epccs/RPUlux/DayNight/README.md

# Day-Night State Machine

## Overview

Use a red LED's photovoltaic voltage on ADC2 to approximately tell when it is day or night. 

Note: use the Day_AttachDayWork() and Night_AttachWork() functions to set a callback that will be run at the start of each day. This framework is how I debuged the day-night stat machine, it is not expected to be useful.

## Firmware Upload

With a serial port connection (see BOOTLOAD_PORT in Makefilee) and optiboot installed on the RPUlux run 'make bootload' and it should compile and then flash the MCU.

``` 
sudo apt-get install make git gcc-avr binutils-avr gdb-avr avr-libc avrdude
git clone https://github.com/epccs/RPUlux/
cd /RPUlux/DayNight
make bootload
...
avrdude done.  Thank you.
``` 

Now connect with picocom (or ilk).

``` 
#exit is C-a, C-x
picocom -b 38400 /dev/ttyUSB0
``` 

# Commands

Commands are interactive over the serial interface at 38400 baud rate. The echo will start after the second character of a new line. 

## /\[rpu_address\]/\[command \[arg\]\]

rpu_address is taken from the I2C address 0x29 (e.g. ../Uart/id.h get_Rpu_address() ). The value of rpu_address is used as a character in a string, which means don't use a null value (C strings are null terminated), but the ASCII value for '1' (0x31) is easy and looks nice.

The LED_BUILTIN is bliked fast (twice per second) if the I2C address is not found, also the rpu_address defaults to '0'. 

Commands and their arguments follow.

## /0/id? \[name|desc|avr-gcc\]

Identify is from ../Uart/id.h Id().

``` 
/1/id?
{"id":{"name":"DayNight","desc":"RPUlux Board /w atmega328p and LT3652","avr-gcc":"4.9"}}
```

##  /0/day?

Report status of the state machine.

``` 
/1/day?
{"day_state":"DAY"}
... 11 hr
{"day_state":"DAY"}
{"day_state":"EVENING"}
... 15 min
{"day_state":"EVENING"}
TurnOnLED's
{"day_state":"NIGHT"}
... 12 hr
{"day_state":"NIGHT"}
{"day_state":"MORNING"}
... 15 min
{"day_state":"MORNING"}
WaterTheGarden
{"day_state":"DAY"}
... 20 hr (e.g. using an indoor lamp)
{"day_state":"DAY"}
{"day_state":"FAIL"}
```
