epccs/RPUlux/Hardware/Design/17323SMD,BOM.csv

LINE | REF | QTY | EPCCS TYP | EPCCS PN | MFG@PN | DESCRIPTION | NOTES | COST EA | LINE COST | BIN
 |  |  |  |  |  | RPUlux SMD |  |  | TOTAL
 |  |  |  |  |  | 2/23/17 (17323^2) |  |  | =SUM(J5:J100)
1 | C1 C6 C7 | 3 | C-C | 1206X5R50V106K | TDK@C3216X5R1H106K160AB | CAP CER 10UF 50V 10% X5R 1206 | (1) | .3575 | =C5*I5 | CC01
2 | C2 C4 C12 C26 C27 C28 C31 | 7 | C-C | 0603X7R50V104K | TDK@C1608X7R1H104K080AA | CAP CER 0.1UF 50V 10% X7R 0603 | (1) | 0.0055 | =C6*I6 | ADPT
3 | C3 C19 C20 C24 C25 | 5 | C-C | 0603X7R50V103K | MURATA@GRM188R71H103KA01J | CAP CER 10000PF 50V 10% X7R 0603 | (1) | 0.007 | =C7*I7 | HT
4 | C5 C9 C10 C11 C13 C14 C15 C16 C17 C18 C21 C22 C23 | 13 | C-C | 0805X7R50V105K | TAIYO@UMK212B7105KG-T | CAP CER 1UF 50V 10% X7R 0805 | (1) | 0.136 | =C8*I8 | CC01
5 | C8 | 1 | C-T | 106A | AVX@TPSA106K010R0900 | CAP TANT 10UF 10V 10% ESR .9OHM 1206 | (1) | 0.3575 | =C9*I9 | ADPT
6 | C29 C30 | 2 | C-C | 0603NPO50V270J | SAMSUNG@CL10C270JB8NNNC | CAP CER 27PF 50V 5% NPO 0603 | (1) | 0.0067 | =C10*I10 | RPUNO
7 | D1 D3 D4 D5 D6 D7 D8 | 7 | D-SBR | SQ4 | DIODES@SBR2A40SA | DIODE SBR 40V 2A SMA | (1) | 0.289 | =C11*I11 | CC01
8 | D9 | 1 | D-GP | T4 | DIODES@1N4148W-7-F | DIODE SWITCH 100V 0.15A SOD123 | (1) | 0.0601 | =C12*I12 | CC01
9 | L1 L2 L3 L4 L5 L6 | 6 | L-PSMD | 33UH1A1 | TAIYO_YUDEN@NR6028T330M | INDUCTOR POWER SHIELDED 33UH 1A1 SMD | (1 2) | 0.3096 | =C13*I13 | LUX
10 | L7 | 0 | L-FB | MH2029-300Y | BORNS@MH2029-300Y | FERRITE SMDBEAD 30OHM@100MHZ 3A 0805 | (1) | 0.0272 | =C14*I14 | ADPT
11 | Q1 Q6 Q10 Q16 Q20 | 5 | Q-NPN | K1N | DIODES@MMBT3904-7-F | TRANSISTOR NPN GP 40V 200MA SOT23 | (1) | 0.0204 | =C15*I15 | IRRIGATE7
12 | Q2 Q4 Q8 | 3 | Q-PCH | P65 | DIODES@DMP4065S-7 | MOSFET P-CH 2.4A 40V SOT23 | (1) | 0.2196 | =C16*I16 | PUNICA
13 | Q3 Q9 Q11 Q17 Q19 Q21 Q22 | 7 | Q-NCH | K38 | DIODES@BSS138-7-F | MOSFET N-CH 200MA 50V SOT23 | (1) | 0.1132 | =C17*I17 | ADPT
14 | Q5 Q7 Q12 Q13 Q18 Q23 | 6 | Q-PNP | K3N | DIODES@MMBT3906-7-F | TRANSISTOR PNP GP 40V 200MA SOT23 | (1) | 0.0204 | =C18*I18 | HT
15 | Q14 Q15 | 2 | Q-NCH | 34N | DIODES@DMN3404L-7 | MOSFET N-CH 5.8A 30V SOT23 | (1) | 0.1351 | =C19*I19 | IRRIGATE7
16 | R1 R11 R14 R15 | 4 | R-C | 0805KX1003 | YAGEO@RC0805FR-07100KL | RESISTOR CHIP 1% 100KOHM 0805 | (1) | 0.0025 | =C20*I20 | IRRIGATE7
17 | R2 R16 R38 | 3 | R-C | 0805KX4992 | YAGEO@RC0805FR-0749K9L | RESISTOR CHIP 1% 49K9OHM 0805 | (1) | 0.0064 | =C21*I21 | IRRIGATE7
18 | R3 R8 R9 R27 R28 R39 R40 R41 | 8 | R-C | 0805KX1002 | YAGEO@RC0805FR-0710KL | RESISTOR CHIP 1% 10KOHM 0805 | (1) | 0.0025 | =C22*I22 | ADPT
19 | R4 | 1 | R-C | 0805KX1001 | YAGEO@RC0805FR-071KL | RESISTOR CHIP 1% 1KOHM 0805 | (1) | 0.0025 | =C23*I23 | HT
20 | R5 R36 | 2 | R-C | 0805FX1003 | YAGEO@RT0805BRD07100KL | RESISTOR CHIP 0.1% 100KOHM 0805 | (1) | 0.1277 | =C24*I24 | LUX
21 | R6 R35 | 2 | R-C | 0805KX1582 | YAGEO@RC0805FR-0715K8L | RESISTOR CHIP 1% 15K8OHM 0805 | (1) | 0.0064 | =C25*I25 | IRRIGATE7
22 | R7 | 1 | R-C | 0805KX0R068 | SAMSUNG@RU2012FR068CS | RESISTOR CHIP 1% 0R068OHM 0805 | (7) | 0.0899 | =C26*I26 | CC03
23 | R10 | 0 |  | JMP |  |  |  | 0.0 | =C27*I27 | NA
24 | R12 | 0 |  | OPEN |  |  |  | 0.0 | =C28*I28 | NA
25 | R13 | 1 | R-C | 0805KX8062 | YAGEO@RC0805FR-0780K6L | RESISTOR CHIP 1% 80K6OHM 0805 | (1) | 0.0064 | =C29*I29 | CC01
26 | R17 R26 | 2 | R-C | 0805KX27R0 | YAGEO@RC0805FR-0727R0L | RESISTOR CHIP 1% 27R0OHM 0805 | (1) | 0.0064 | =C30*I30 | FTDI
27 | R18 R20 R22 R29 R31 R33 | 6 | R-C | 0805KX0R300 | SUSUMU@RL1220S-R30-F | RESISTOR CHIP 1% 0R300OHM 0805 | (7) | 0.1043 | =C31*I31 | LUX
28 | R19 R21 R23 R30 R32 R34 | 6 | R-C | 0805KX3741 | YAGEO@RC0805FR-073K74L | RESISTOR CHIP 1% 3K74OHM 0805 | (1) | 0.0064 | =C32*I32 | PDAQ
29 | R24 R25 R37 | 3 | R-C | 0805KX127R | YAGEO@RC0805FR-07127RL | RESISTOR CHIP 1% 127OHM 0805 | (1) | 0.0024 | =C33*I33 | PUNICA
30 | U1 | 1 | U-LINEAR | 1087 | DIODES@ZXCT1087E5TA | HISIDE CURRENT MONITOR SOT23-5 | (1) | 1.0661 | =C34*I34 | CCTEST
31 | U3 U4 U5 U6 U7 U8 | 6 | U-LINEAR | A6 | DIODES@AL8805W5-7 | CURR DRIVER SOT23-5 | (1) | 0.8110 | =C35*I35 | LUX
32 | U9 | 1 | U-AVR | MEGA328P | ATMEL@ATMEGA328P-AU | MCU AVR8 32KB FLASH 20MHZ 32TQFP | () | 1.9504 | =C36*I36 | RPUNO
33 | Y1 | 1 | Y-XTL | 16MHZ20 | ECS@ECS-160-20-3X-TR | CRYSTAL 16MHZ 20PF 30PPM CSM-3X | (1) | 0.315 | =C37*I37 | RPUNO
 |  |  |  |  |  | NOTES
 |  |  |  |  |  | (1) Alternate part with same or better rating allowed
 |  |  |  |  |  | (2) SMD pads are wide but also works with TAIYO_YUDEN@NR5040T330M
