epccs/RPUlux/SelfTest/README.md

# Self-Test

## Overview

Check RPUlux Board Functions, runs once after a reset and then loops in a pass/fail section.

Voltage references are saved in EEPROM for use with Adc and other applications. Measure the +5V supply accurately and set the REF_EXTERN_AVCC value in the main.c file. The band-gap reference is calculated and also saved.

The wiring has red and green LED that blink to indicate test status.

## Wiring Needed for RPUlux

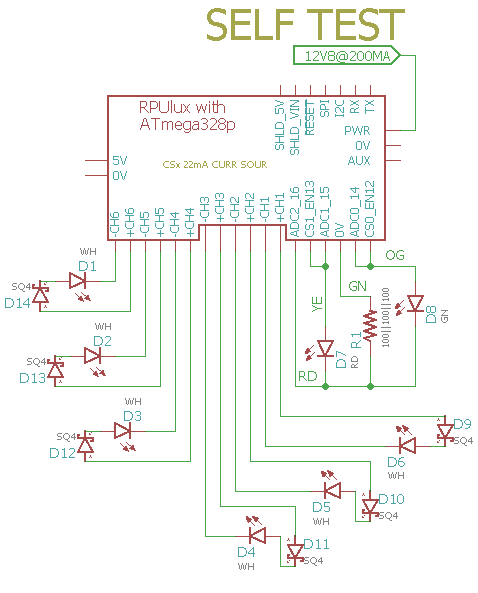
[picture p29: SelfTest/Setup/SelfTestWiring.png]
Wiring


Note: blocking diode with LED is to prevent damage when connected wrong.

## Power Supply

Connect a power supply with CV and CC mode. Set CC at 300mA then increase CV to 12.8V.

## Firmware Upload

With a serial port setup for serial bootloading (see BOOT_PORT in Makefile) and optiboot installed on the RPUlux run 'make bootload' and it should build the code and then flash the MCU.

``` 
git clone https://github.com/epccs/RPUlux/
cd /RPUlux/SelfTest
make bootload
...
avrdude done.  Thank you.
make clean
``` 

Now connect with picocom (exit is C-a, C-x). 

``` 
picocom -b 38400 /dev/ttyUSB0
picocom v2.2
...
Terminal ready
RPUlux Self Test date: Mar 27 2018
avr-gcc --version: 5.4.0
I2C provided address 0x31 from serial bus manager
adc reading for PWR_V: 359
PWR at: 12.812 V
ADC0 GN LED /W SINK on and CS*_EN off: 0.000 V
ADC1 RD LED /W SINK on and CS*_EN off: 0.000 V
ADC2 R1 /W CS*_EN off: 0.000 V
ADC3 R1 /W CS*_EN off: 0.000 V
CS0 curr source on R1: 0.022 A
Green LED fwd V: 2.245 V
CS1 curr source on R1: 0.022 A
Red LED fwd V: 2.133 V
   ADC2 reading used to calculate ref_intern_1v1_uV: 696 A
   calculated ref_intern_1v1_uV: 1088918 uV
REF_EXTERN_AVCC old value was in eeprom: 4948800 uV
REF_INTERN_1V1 old value was in eeprom: 1078310 uV
REF_EXTERN_AVCC saved in eeprom: 4986100 uV
REF_INTERN_1V1 saved in eeprom: 1088918 uV
PWR_I with !CS1_EN use INTERNAL_1V1: 0.013 A
PWR_I with CH1 LED, 1V1, 1sec: 0.121 A
PWR_I with CH1 LED, 1V1, 3sec: 0.121 A
Approximate CH1 curr on a 3.2V LED: 0.344 A
Approximate CH1 curr /w weak pull-up on a 3.2V LED: 0.091 A
PWR_I with CH2 LED, 1V1, 1sec: 0.119 A
PWR_I with CH2 LED, 1V1, 3sec: 0.119 A
Approximate CH2 curr on a 3.2V LED: 0.337 A
Approximate CH2 curr /w weak pull-up on a 3.2V LED: 0.091 A
PWR_I with CH3 LED, 1V1, 1sec: 0.117 A
PWR_I with CH3 LED, 1V1, 3sec: 0.117 A
Approximate CH3 curr on a 3.2V LED: 0.331 A
Approximate CH3 curr /w weak pull-up on a 3.2V LED: 0.088 A
PWR_I with CH4 LED, 1V1, 1sec: 0.119 A
PWR_I with CH4 LED, 1V1, 3sec: 0.118 A
Approximate CH4 curr on a 3.2V LED: 0.336 A
Approximate CH4 curr /w weak pull-up on a 3.2V LED: 0.090 A
PWR_I with CH5 LED, 1V1, 1sec: 0.117 A
PWR_I with CH5 LED, 1V1, 3sec: 0.117 A
Approximate CH5 curr on a 3.2V LED: 0.332 A
Approximate CH5 curr /w weak pull-up on a 3.2V LED: 0.088 A
PWR_I with CH6 LED, 1V1, 1sec: 0.120 A
PWR_I with CH6 LED, 1V1, 3sec: 0.120 A
Approximate CH6 curr on a 3.2V LED: 0.342 A
Approximate CH6 curr /w weak pull-up on a 3.2V LED: 0.092 A
[PASS]
```

For the current shown for CH1..CH6 it is assumed 80% of the input power is turned into current thrugh the LED.
