epccs/RPUlux/Hardware/Documents/17323,Schematic.pdf

# CURRENT SOURCE FOR LOOPS

## POWER 7-36V

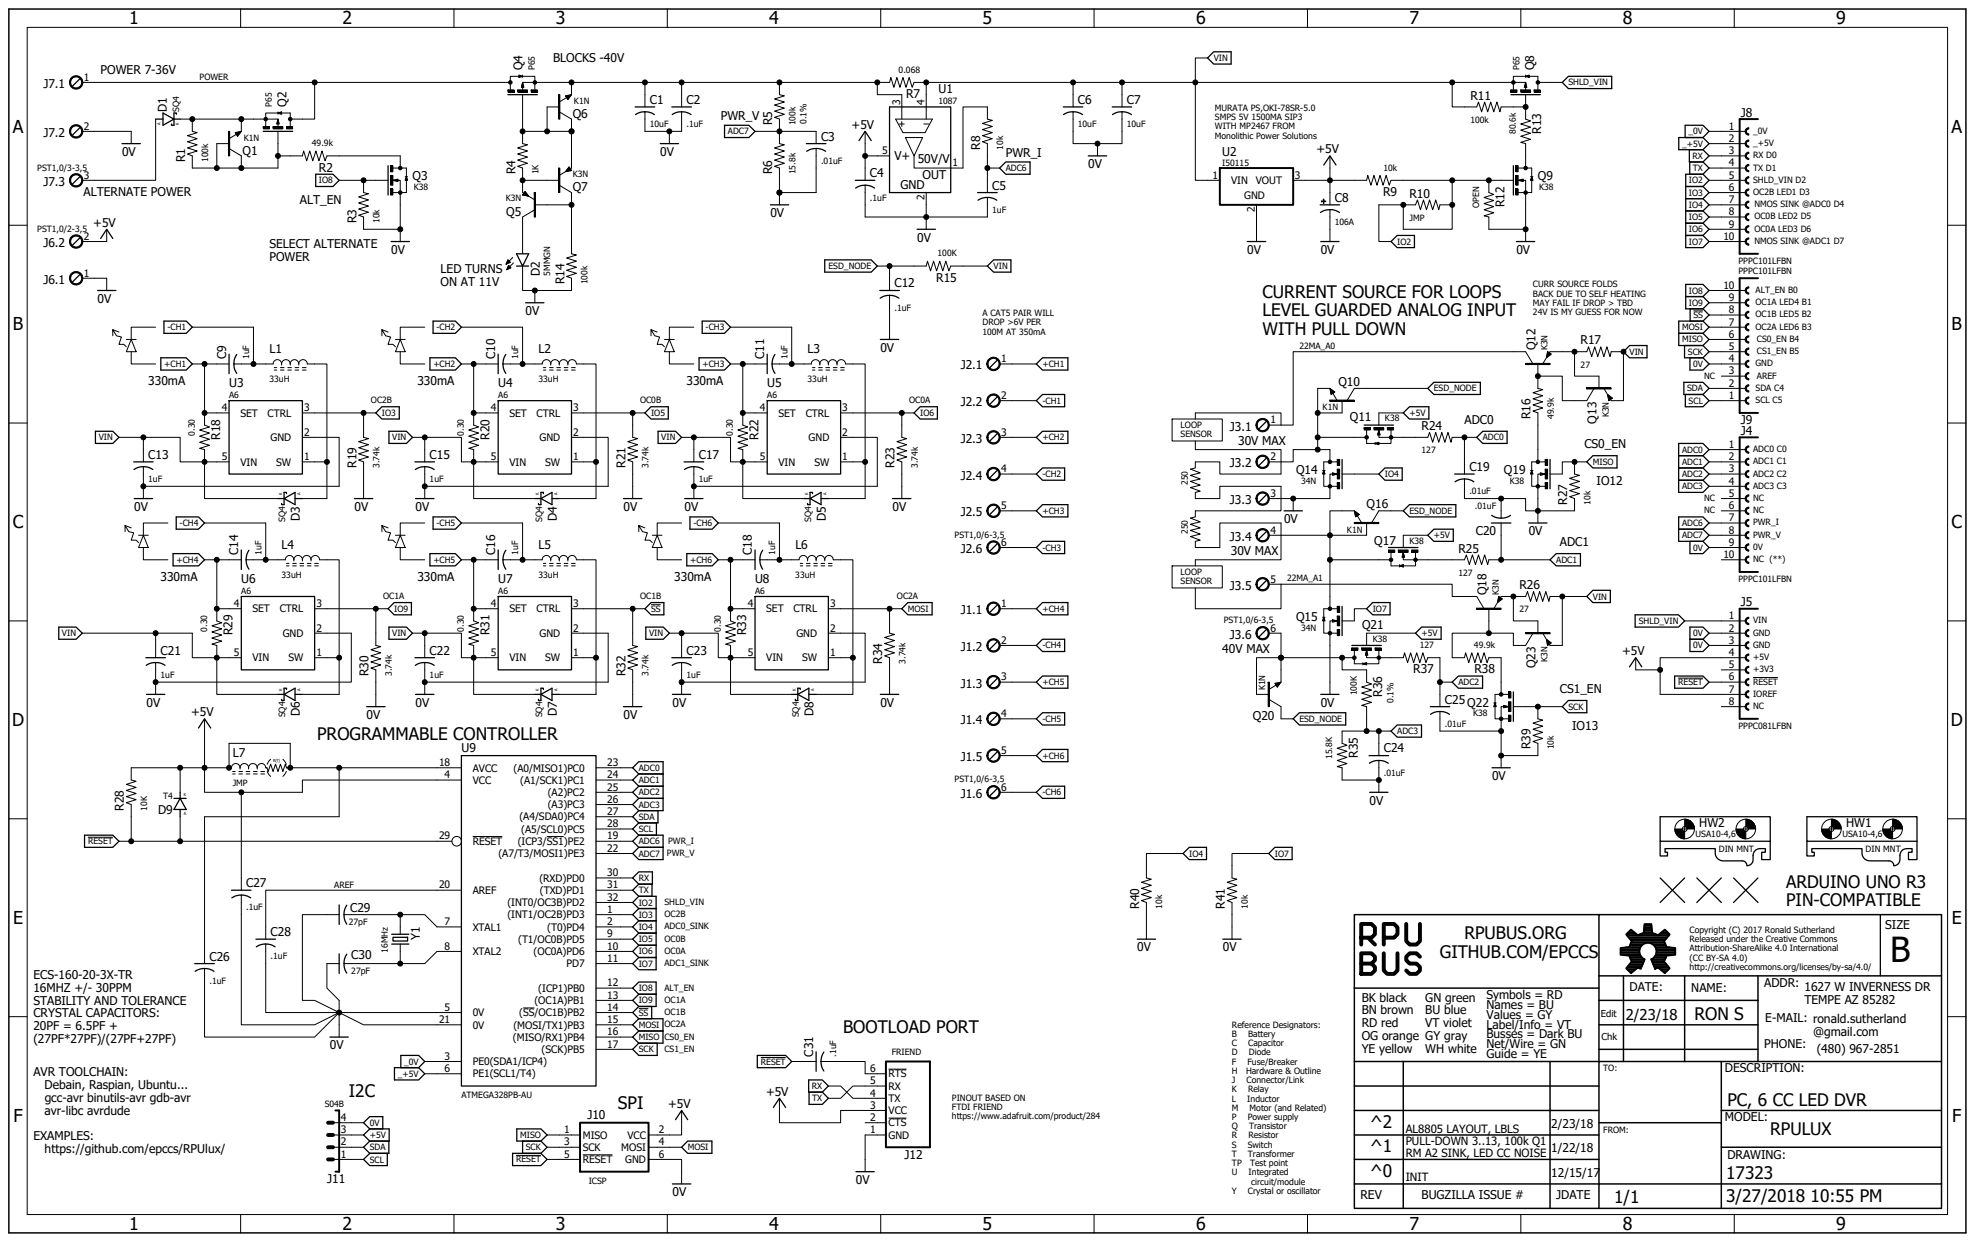
[picture p34: page 1]

CURR SOURCE FOLDS
BACK DUE TO SELF HEATING
MAY FAIL IF DROP > TBD
24V IS MY GUESS FOR NOW

LEVEL GUARDED ANALOG INPUT
WITH PULL DOWN

Copyright (C) 2017 Ronald Sutherland
Released under the Creative Commons
Attribution-ShareAlike 4.0 International
http://creativecommons.org/licenses/by-sa/4.0/

Edit | 2/23/18 | RON S

Chk

AVR TOOLCHAIN:
Debain, Raspian, Ubuntu...
gcc-avr binutils-avr gdb-avr
avr-libc avrdude
EXAMPLES:
https://github.com/epccs/RPUlux/

PINOUT BASED ON
FTDI FRIEND
https://www.adafruit.com/product/284

^0 | | 12/15/17 INIT
REV | BUGZILLA ISSUE # | JDATE
