epccs/RPUlux/Hardware/Documents/17323,tAssy.pdf

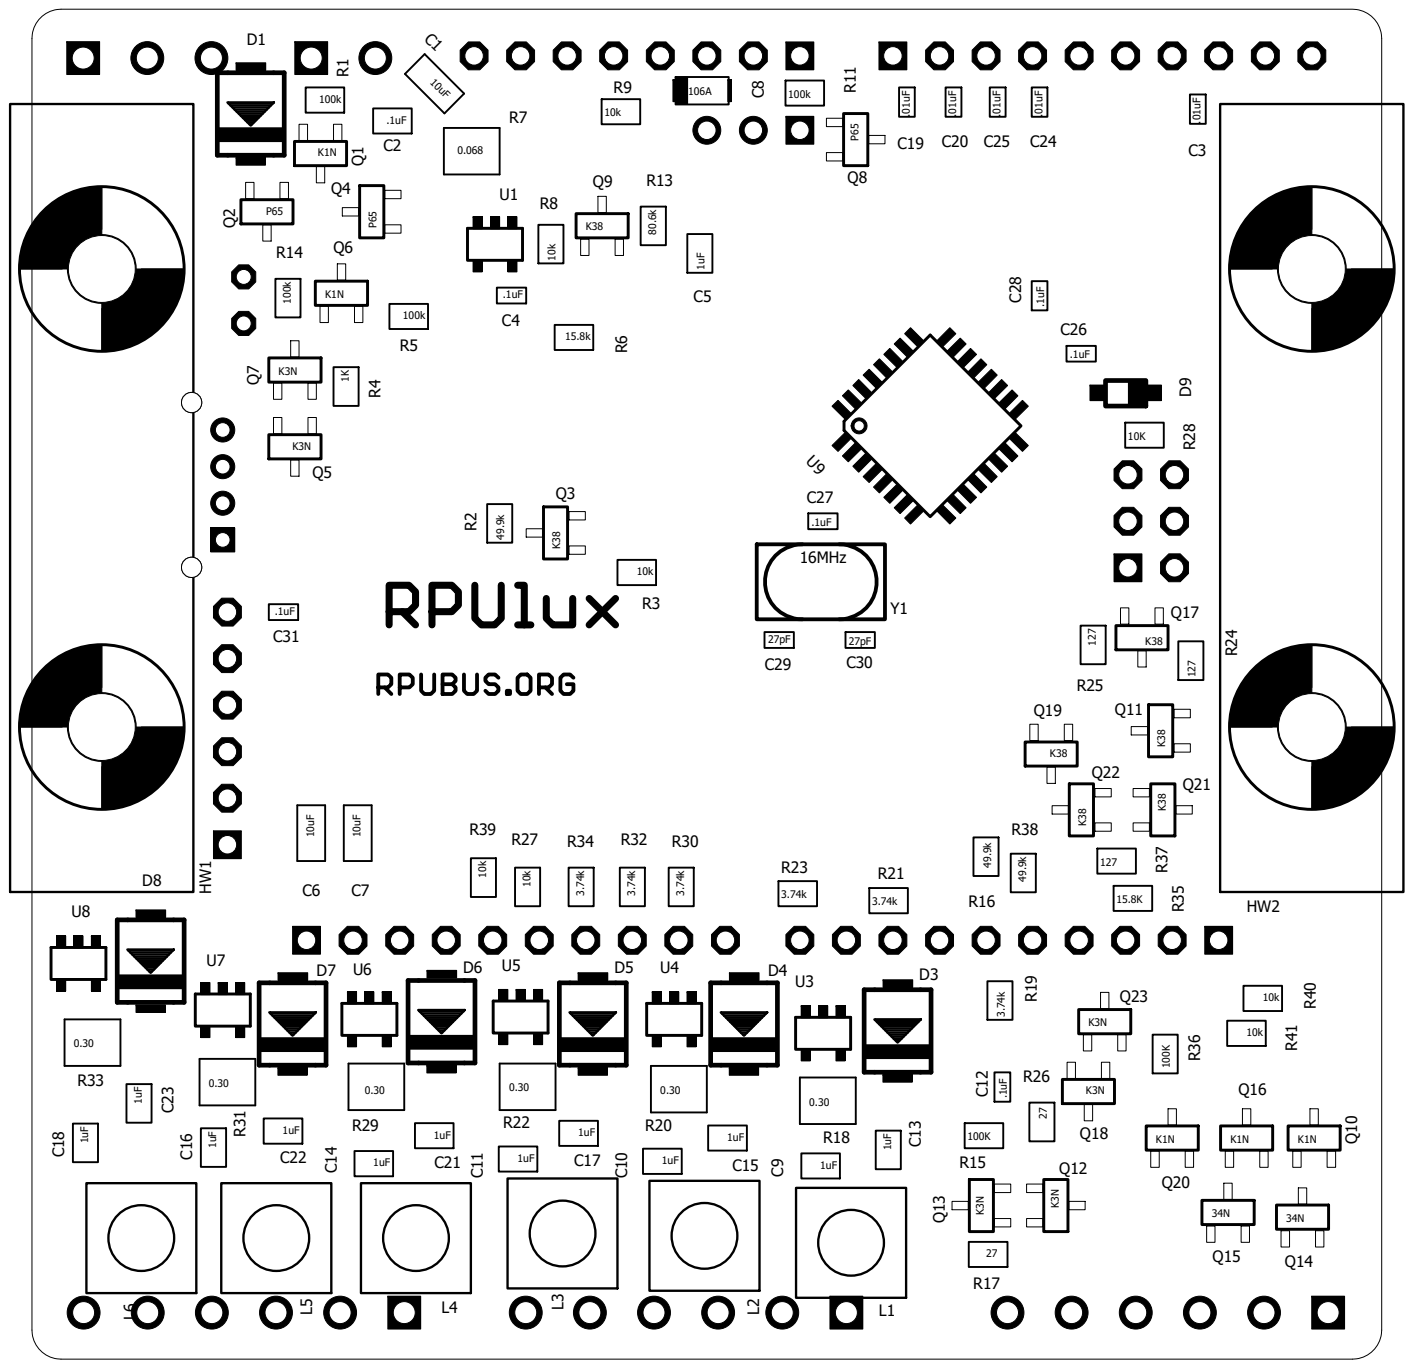
[picture p35: page 1]
