epccs/RPUlux/Hardware/Documents/17323,bAssy.pdf

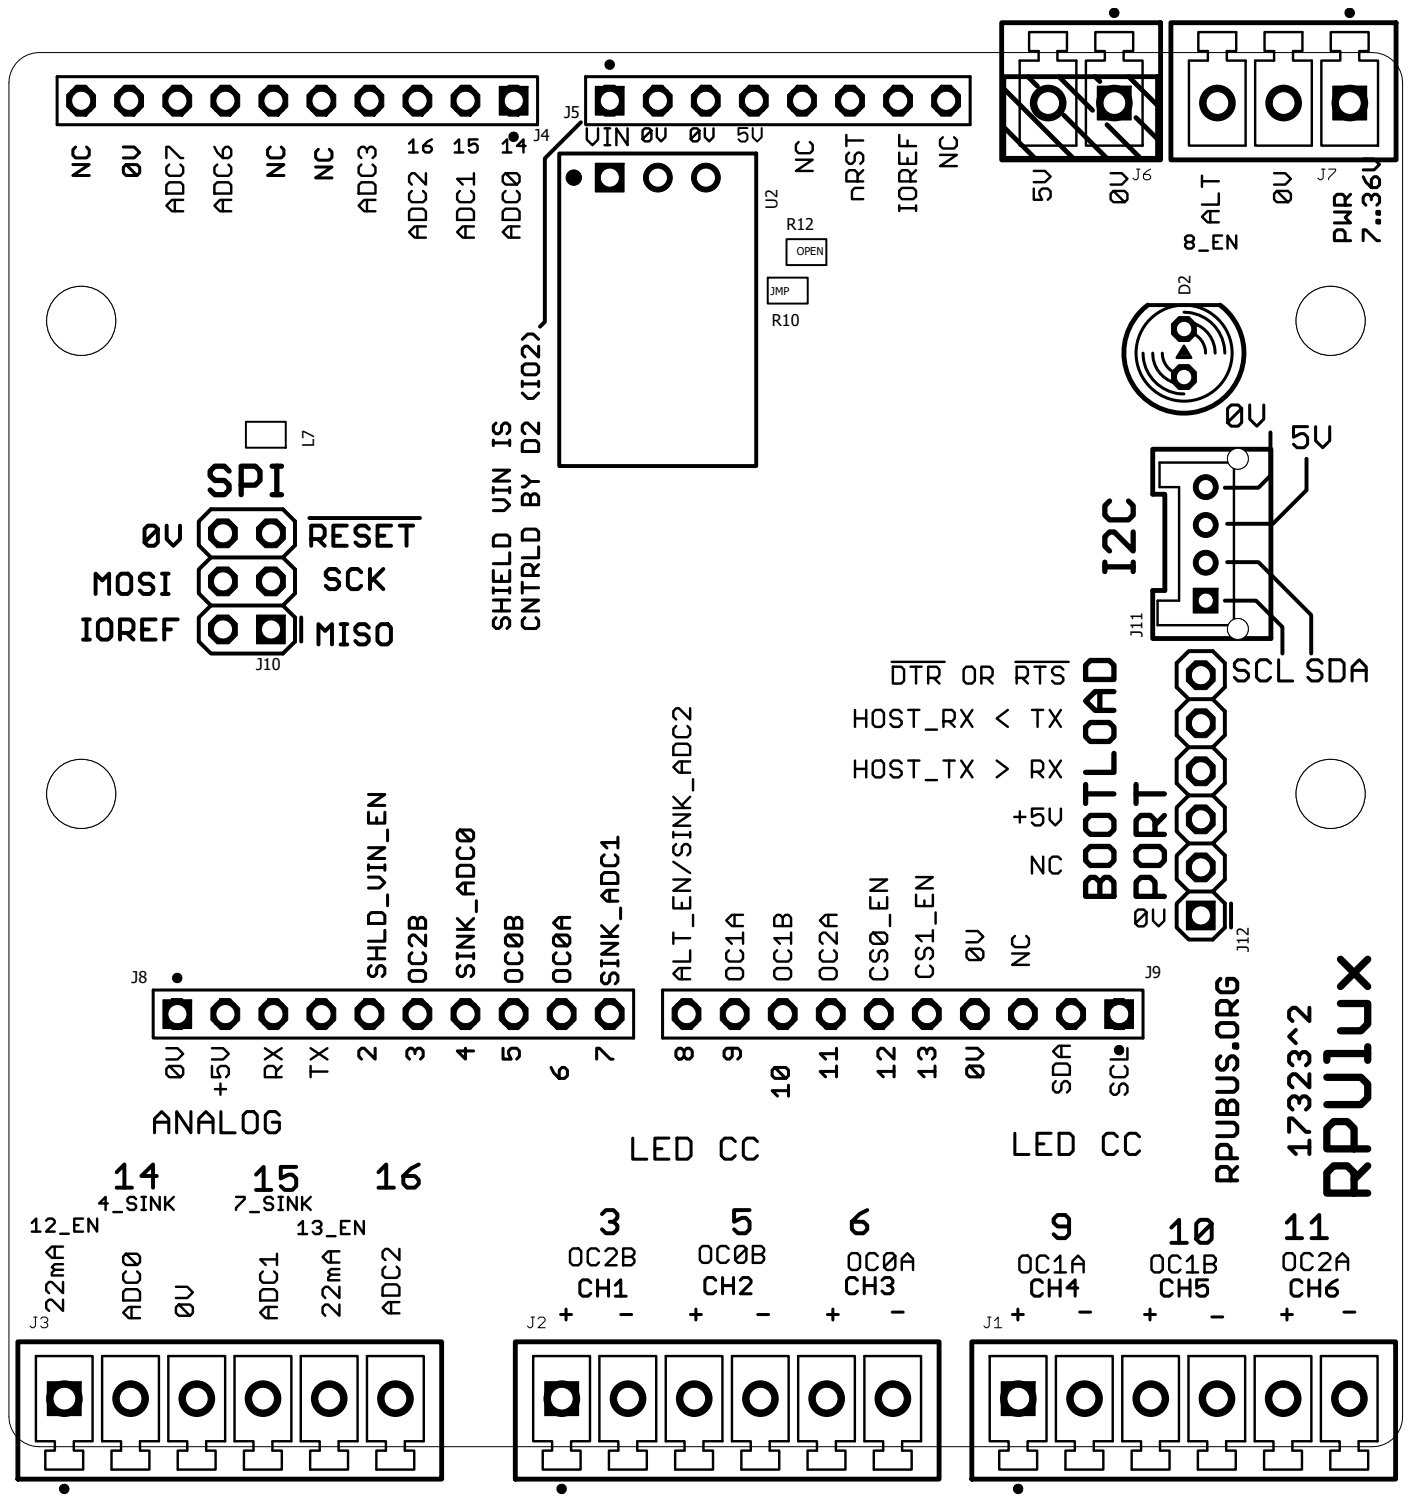
[picture p36: page 1]
