epccs/RPUlux/Alternat/Setup/AuxilaryWiring.sch

## EAGLE design Alternat/Setup/AuxilaryWiring.sch (2018-01-22)

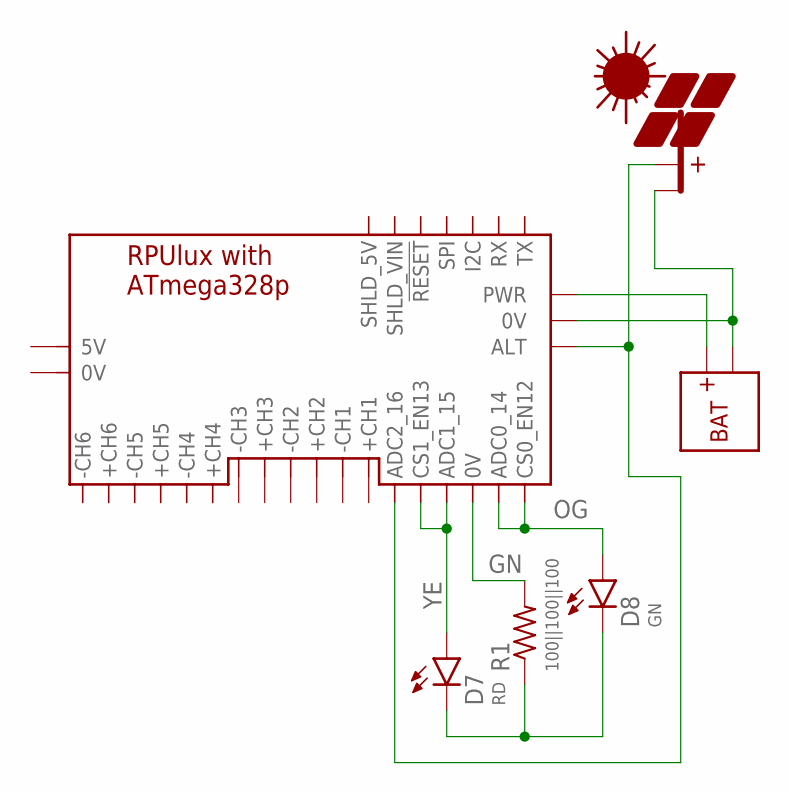
[picture p37: schematic AuxilaryWiring.sch]

Parts:
D7: RD; LED5MM
D8: GN; LED5MM
PV4: PV; NA-30
R1: 100||100||100; C0805(2012)
U$1: RPULUX; WITH_RPU_NAMES
U$7: BAT; NA-30

Connections:
GN: R1.2, U$1.0V@DIO2 (0V)
unnamed: U$1.PWR, U$7.1 (+BAT)
unnamed: PV4.2 (-PV), U$1.0V@PWR (0V), U$7.2 (-BAT)
unnamed: PV4.1 (+PV), U$1.ADC2 (ADC2_16), U$1.AUX (ALT)
OG: D8.A, U$1.22MA@ADC0 (CS0_EN12), U$1.ADC0 (ADC0_14)
RD: D7.K, D8.K, R1.1
YE: D7.A, U$1.22MA@ADC1 (CS1_EN13), U$1.ADC1 (ADC1_15)
