epccs/RPUlux/Hardware/Design/MultiDrop.sch

## EAGLE design Hardware/Design/MultiDrop.sch (2018-02-22)

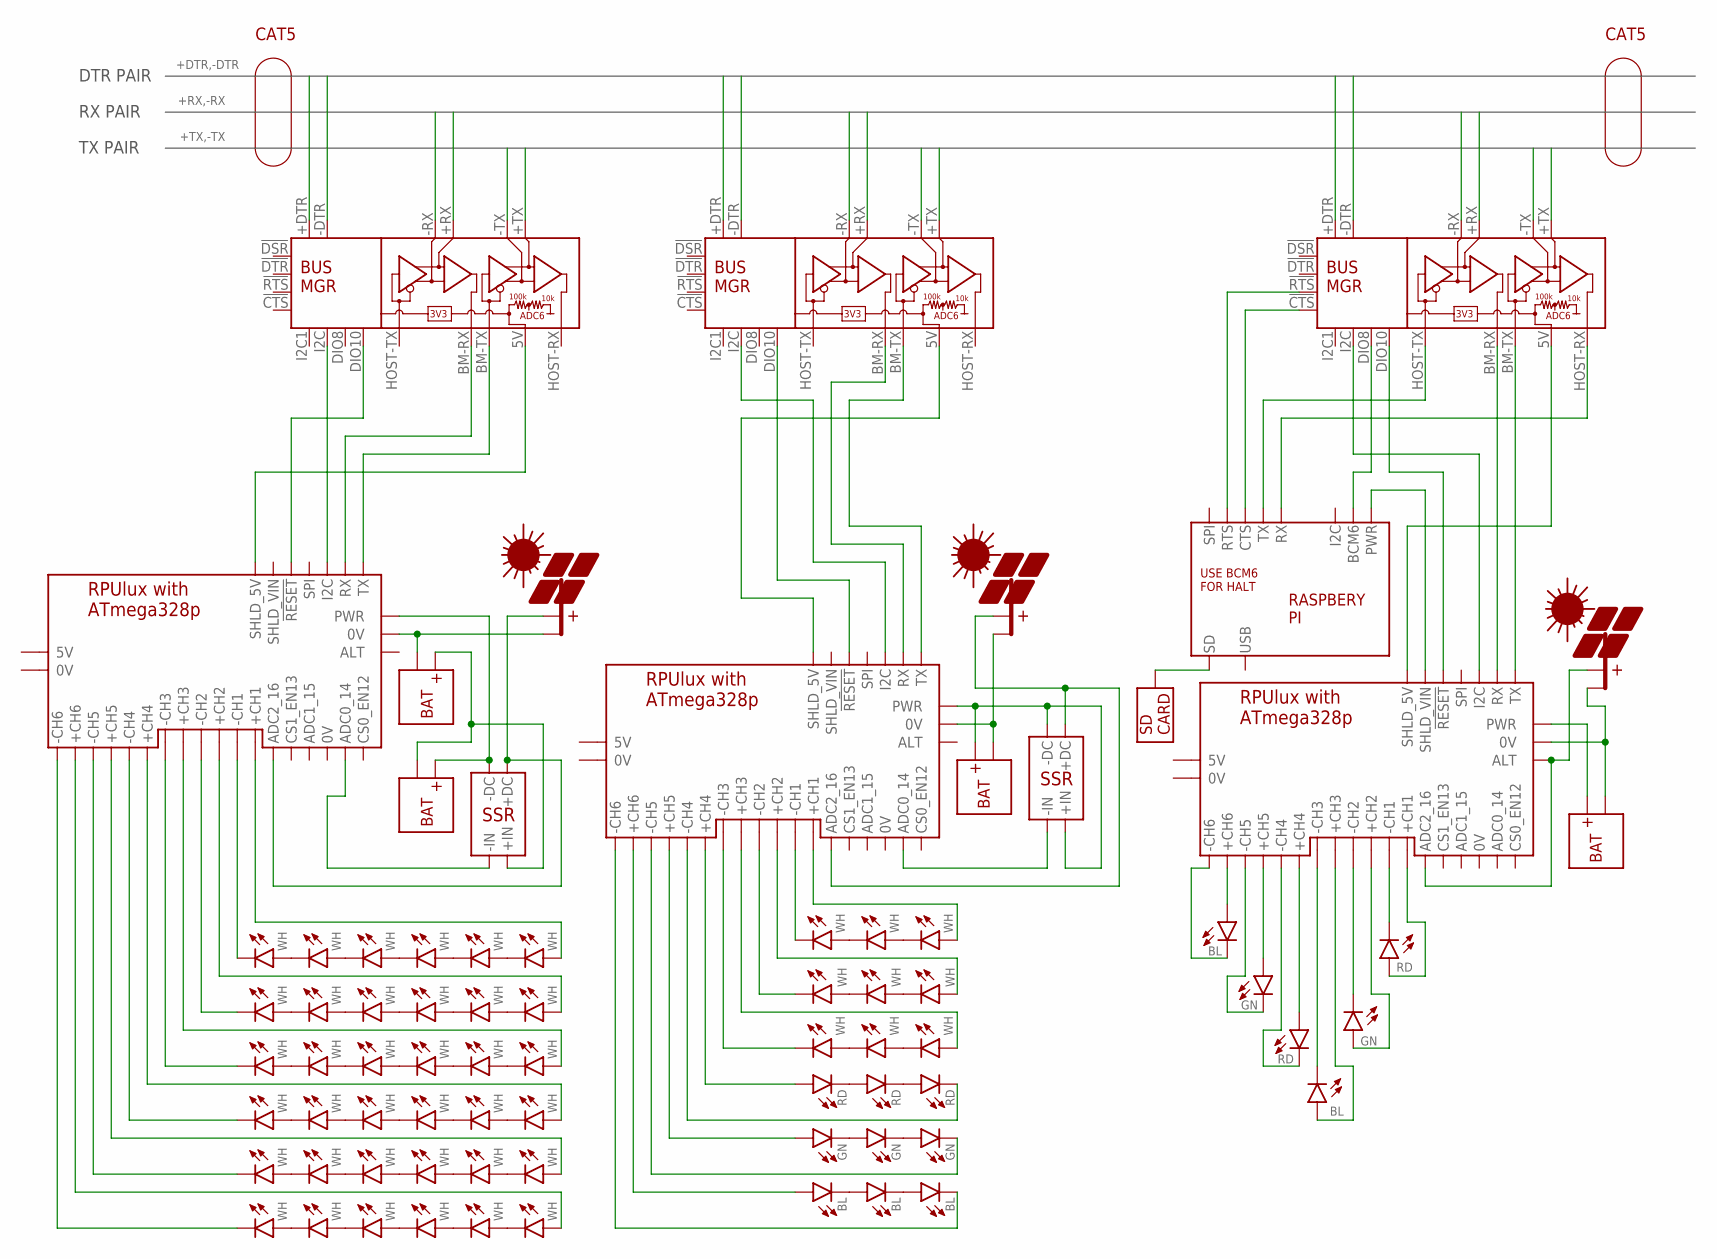
[picture p38: schematic MultiDrop.sch]

Parts:
B1, B3, B4: WH; LED5MM
B2: BL; LED5MM
BL1, BL3, BL4, BL5: GN; LED5MM
G1, G3, G4: WH; LED5MM
G2: GN; LED5MM
GN1, GN3, GN4, GN5: BL; LED5MM
PV1, PV2, PV4: PV; NA-30
R1, R3, R4, R5, R6, R7, R8, R9, R10, R11, R12, R13, R14, R15, R16, R17, R18, R19, R20, R21, R22, R23, R24, R25, R26, R27, R28, R29, R30, R31, R32, R33, R34, R35, R36, R37, R38, R39, R40: WH; LED5MM
R2: RD; LED5MM
RD1, RD3, RD4, RD5: RD; LED5MM
SD2: SD; NA-30
U$1, U$2, U$4: BUS_MGR; WITH_RPU_NAMES
U$3: PI; NA-30
U$5, U$6, U$8: RPULUX; WITH_RPU_NAMES
U$7, U$9, U$10, U$11: BAT; NA-30
U$12, U$13: SSR_DC; NA-30

Connections:
+DTR: U$4.+DTR
+DTR1: U$2.+DTR
+DTR3: U$1.+DTR
+RX: U$4.+RX
+RX1: U$2.+RX
+RX3: U$1.+RX
+TX: U$4.+TX
+TX1: U$2.+TX
+TX3: U$1.+TX
-DTR: U$4.-DTR
-DTR1: U$2.-DTR
-DTR3: U$1.-DTR
-RX: U$4.-RX
-RX1: U$2.-RX
-RX3: U$1.-RX
-TX: U$4.-TX
-TX1: U$2.-TX
-TX3: U$1.-TX
unnamed: U$4.BM-TX (BM_TX), U$8.TX
unnamed: U$4.BM-RX (BM_RX), U$8.RX
unnamed: PV1.1 (+PV), U$8.ADC2 (ADC2_16), U$13.1 (+DC)
unnamed: R5.K, R10.A
unnamed: R8.A, U$8.+CH1
unnamed: R9.A, R10.K
unnamed: R5.A, R6.K
unnamed: R6.A, R7.K
unnamed: U$2.BM-TX (BM_TX), U$5.TX
unnamed: U$2.BM-RX (BM_RX), U$5.RX
unnamed: U$1.DIO8, U$3.7 (BCM6)
unnamed: U$1.5V (PWR), U$6.SHLD_5V
unnamed: U$1.BM-TX (BM_TX), U$6.TX
unnamed: U$6.PWR, U$7.1 (+BAT)
unnamed: U$10.1 (+BAT), U$11.2 (-BAT), U$13.2 (+IN)
unnamed: R7.A, R8.K
unnamed: U$5.PWR, U$9.1 (+BAT), U$12.2 (+IN), U$12.3 (-DC)
unnamed: R11.A, R12.K
unnamed: R12.A, R13.K
unnamed: U$1.BM-RX (BM_RX), U$6.RX
unnamed: U$1.!CTS, U$3.1 (CTS)
unnamed: U$1.!RTS, U$3.2 (RTS)
unnamed: R13.A, R14.K
unnamed: GN1.A, U$5.+CH6
unnamed: U$1.HOST-RX (HOST_RX), U$3.3 (RX)
unnamed: U$1.HOST-TX (HOST_TX), U$3.4 (TX)
unnamed: SD2.1, U$3.9 (SD)
unnamed: U$4.5V (PWR), U$8.SHLD_5V
unnamed: U$4.DIO10, U$8.!RESET
unnamed: R14.A, R15.K
unnamed: U$1.I2C, U$6.I2C
unnamed: U$4.I2C, U$8.I2C
unnamed: R15.A, R16.K
unnamed: R16.A, U$8.+CH2
unnamed: GN3.A, U$6.+CH6
unnamed: R11.K, U$8.-CH2
unnamed: U$8.PWR, U$11.1 (+BAT), U$13.3 (-DC)
unnamed: PV2.2 (-PV), U$5.0V@PWR (0V), U$9.2 (-BAT)
unnamed: U$3.12 (PWR), U$6.SHLD_VOUT (SHLD_VIN)
unnamed: PV4.2 (-PV), U$6.0V@PWR (0V), U$7.2 (-BAT)
unnamed: U$1.DIO10, U$6.!RESET
unnamed: U$2.DIO10, U$5.!RESET
unnamed: U$2.5V (PWR), U$5.SHLD_5V
unnamed: U$2.I2C, U$5.I2C
unnamed: PV4.1 (+PV), U$6.ADC2 (ADC2_16), U$6.AUX (ALT)
unnamed: RD1.A, U$5.+CH4
unnamed: RD5.K, U$5.-CH4
unnamed: BL1.A, U$5.+CH5
unnamed: BL5.K, U$5.-CH5
unnamed: R1.A, R3.K
unnamed: GN5.K, U$5.-CH6
unnamed: R1.K, U$5.-CH1
unnamed: R4.A, U$5.+CH1
unnamed: G4.A, U$5.+CH2
unnamed: G1.K, U$5.-CH2
unnamed: B4.A, U$5.+CH3
unnamed: B1.K, U$5.-CH3
unnamed: R3.A, R4.K
unnamed: G3.A, G4.K
unnamed: G1.A, G3.K
unnamed: B3.A, B4.K
unnamed: B1.A, B3.K
unnamed: GN1.K, GN4.A
unnamed: GN4.K, GN5.A
unnamed: BL1.K, BL4.A
unnamed: BL4.K, BL5.A
unnamed: RD1.K, RD4.A
unnamed: RD4.K, RD5.A
unnamed: PV2.1 (+PV), U$5.ADC2 (ADC2_16), U$12.1 (+DC)
unnamed: U$5.ADC0 (ADC0_14), U$12.4 (-IN)
unnamed: R17.K, R21.A
unnamed: R18.K, R22.A
unnamed: R19.K, R23.A
unnamed: R9.K, U$8.-CH1
unnamed: R20.K, R24.A
unnamed: R21.K, R25.A
unnamed: R22.K, R26.A
unnamed: R23.K, R27.A
unnamed: R24.K, R28.A
unnamed: R25.K, R29.A
unnamed: R26.K, R30.A
unnamed: R27.K, R31.A
unnamed: R28.K, R32.A
unnamed: R29.K, R33.A
unnamed: R30.K, R34.A
unnamed: R31.K, R35.A
unnamed: R32.K, R36.A
unnamed: R33.K, R37.A
unnamed: R34.K, R38.A
unnamed: R35.K, R39.A
unnamed: R36.K, R40.A
unnamed: R17.A, U$8.+CH3
unnamed: R37.K, U$8.-CH3
unnamed: R18.A, U$8.+CH4
unnamed: R38.K, U$8.-CH4
unnamed: R19.A, U$8.+CH5
unnamed: R39.K, U$8.-CH5
unnamed: R20.A, U$8.+CH6
unnamed: R40.K, U$8.-CH6
unnamed: PV1.2 (-PV), U$8.0V@PWR (0V), U$10.2 (-BAT)
unnamed: U$8.ADC0 (ADC0_14), U$13.4 (-IN)

Notes on the sheet:
CAT5
DTR PAIR
RX PAIR
TX PAIR
