epccs/RPUlux/Hardware/Design/SolarPwrOption_open.sch

## EAGLE design Hardware/Design/SolarPwrOption_open.sch (2018-02-07)

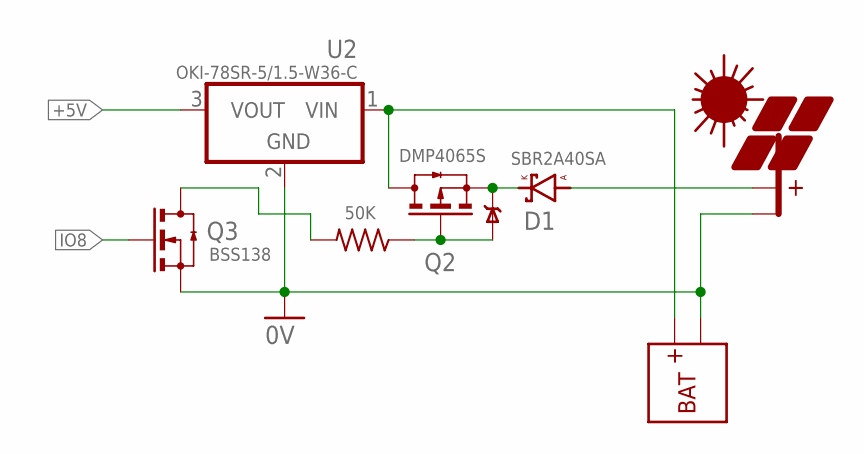
[picture p39: schematic SolarPwrOption_open.sch]

Parts:
D1: SBR2A40SA; SMB
D3: TVSSMC; SMC
PV2: PV; NA-30
Q2: DMP4065S; DPAK
Q3: BSS138; DPAK
R2: 50K; C0805(2012)
U2: OKI-78SR-5/1.5-W36-C; OKI-78SR-H
U$1: BAT; NA-30

Connections:
0V: PV2.2 (-PV), Q3.3 (S), U2.2 (GND), U$1.2 (-BAT)
+5V: U2.3 (VOUT)
IO8: Q3.1 (G)
unnamed: D1.K, D3.C, Q2.3 (S)
unnamed: Q2.SINK (D), U2.1 (VIN), U$1.1 (+BAT)
unnamed: D3.A, Q2.1 (G), R2.1
unnamed: Q3.SINK (D), R2.2
unnamed: D1.A, PV2.1 (+PV)
