epccs/RPUlux/Hardware/Design/SolarPwrOption_ssr.sch

## EAGLE design Hardware/Design/SolarPwrOption_ssr.sch (2018-04-04)

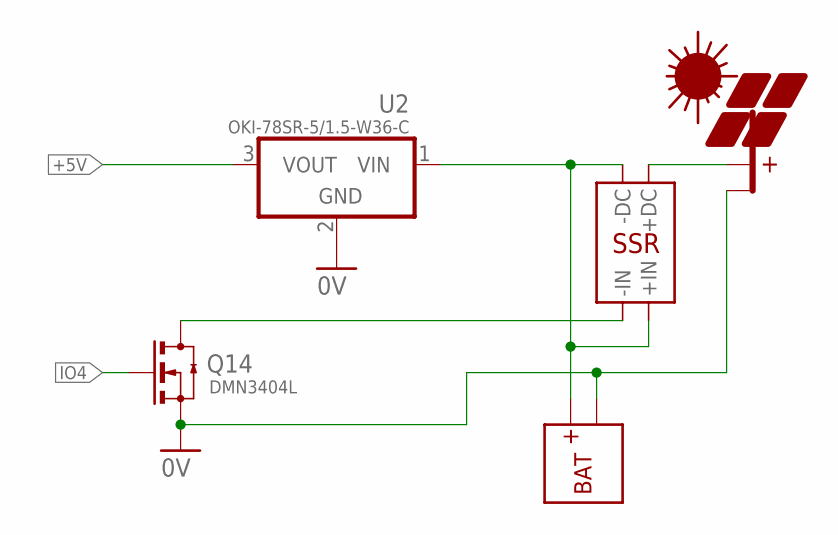
[picture p40: schematic SolarPwrOption_ssr.sch]

Parts:
PV3: PV; NA-30
Q14: DMN3404L; DPAK
U2: OKI-78SR-5/1.5-W36-C; OKI-78SR-H
U$2: BAT; NA-30
U$3: SSR_DC; NA-30

Connections:
0V: PV3.2 (-PV), Q14.3 (S), U2.2 (GND), U$2.2 (-BAT)
+5V: U2.3 (VOUT)
IO4: Q14.1 (G)
unnamed: U2.1 (VIN), U$2.1 (+BAT), U$3.2 (+IN), U$3.3 (-DC)
unnamed: Q14.SINK (D), U$3.4 (-IN)
unnamed: PV3.1 (+PV), U$3.1 (+DC)
