epccs/RPUlux/Hardware/Design/SolarPwrOptions.sch

## EAGLE design Hardware/Design/SolarPwrOptions.sch (2018-02-07)

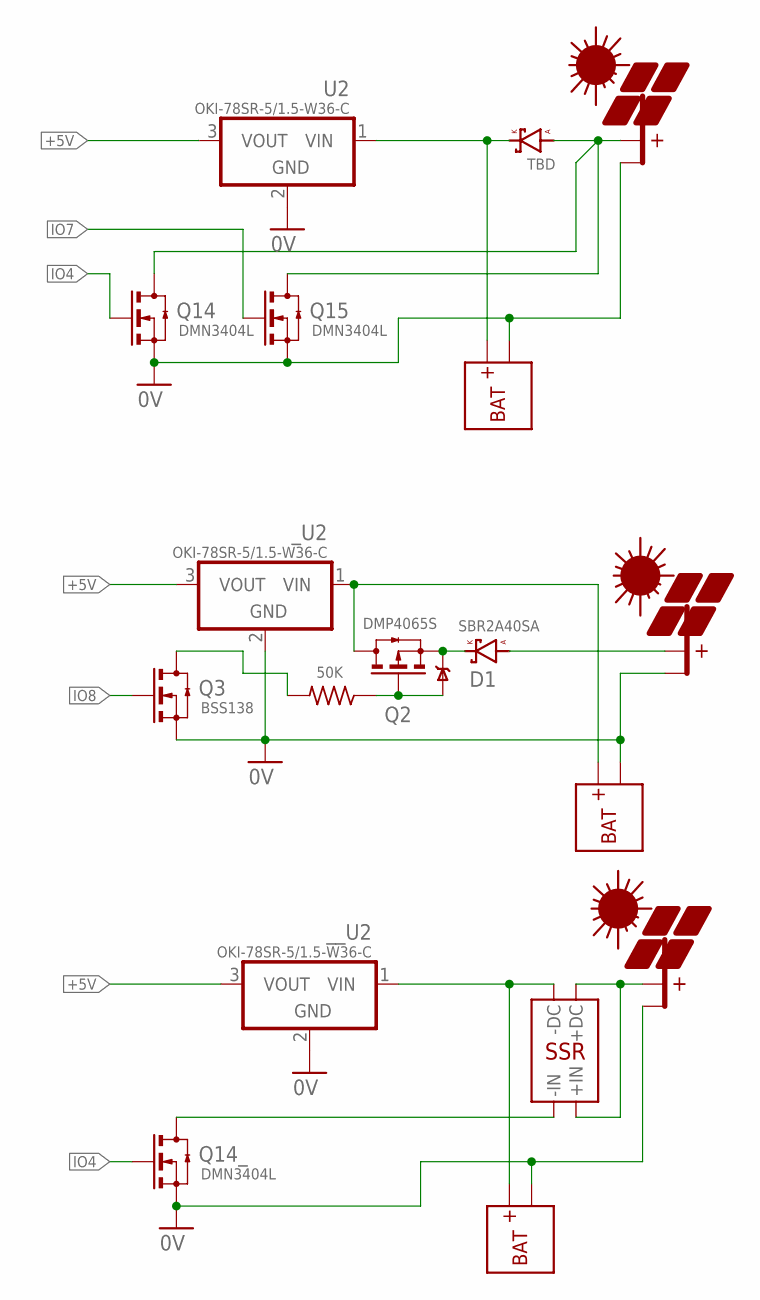
[picture p41: schematic SolarPwrOptions.sch]

Parts:
D1: SBR2A40SA; SMB
D3: TVSSMC; SMC
PV1, PV2, PV3: PV; NA-30
Q2: DMP4065S; DPAK
Q3: BSS138; DPAK
Q14, Q14_, Q15: DMN3404L; DPAK
R2: 50K; C0805(2012)
U2: OKI-78SR-5/1.5-W36-C; OKI-78SR-H
U$1, U$2, U$10: BAT; NA-30
U$3: SSR_DC; NA-30
_D1: TBD; SMB
_U2: OKI-78SR-5/1.5-W36-C; OKI-78SR-H
__U2: OKI-78SR-5/1.5-W36-C; OKI-78SR-H

Connections:
0V: PV1.2 (-PV), PV2.2 (-PV), PV3.2 (-PV), Q3.3 (S), Q14.3 (S), Q14_.3 (S), Q15.3 (S), U2.2 (GND), U$1.2 (-BAT), U$2.2 (-BAT), U$10.2 (-BAT), _U2.2 (GND), __U2.2 (GND)
+5V: U2.3 (VOUT), _U2.3 (VOUT), __U2.3 (VOUT)
IO4: Q14.1 (G), Q14_.1 (G)
IO7: Q15.1 (G)
IO8: Q3.1 (G)
unnamed: D1.K, D3.C, Q2.3 (S)
unnamed: Q2.SINK (D), U$1.1 (+BAT), _U2.1 (VIN)
unnamed: D3.A, Q2.1 (G), R2.1
unnamed: U2.1 (VIN), U$10.1 (+BAT), _D1.K
unnamed: Q3.SINK (D), R2.2
unnamed: U$2.1 (+BAT), U$3.3 (-DC), __U2.1 (VIN)
unnamed: D1.A, PV2.1 (+PV)
unnamed: PV1.1 (+PV), Q14.SINK (D), Q15.SINK (D), _D1.A
unnamed: Q14_.SINK (D), U$3.4 (-IN)
unnamed: PV3.1 (+PV), U$3.1 (+DC), U$3.2 (+IN)
