epccs/RPUlux/NightLight/Setup/NightLightWiring.sch

## EAGLE design NightLight/Setup/NightLightWiring.sch (2018-02-06)

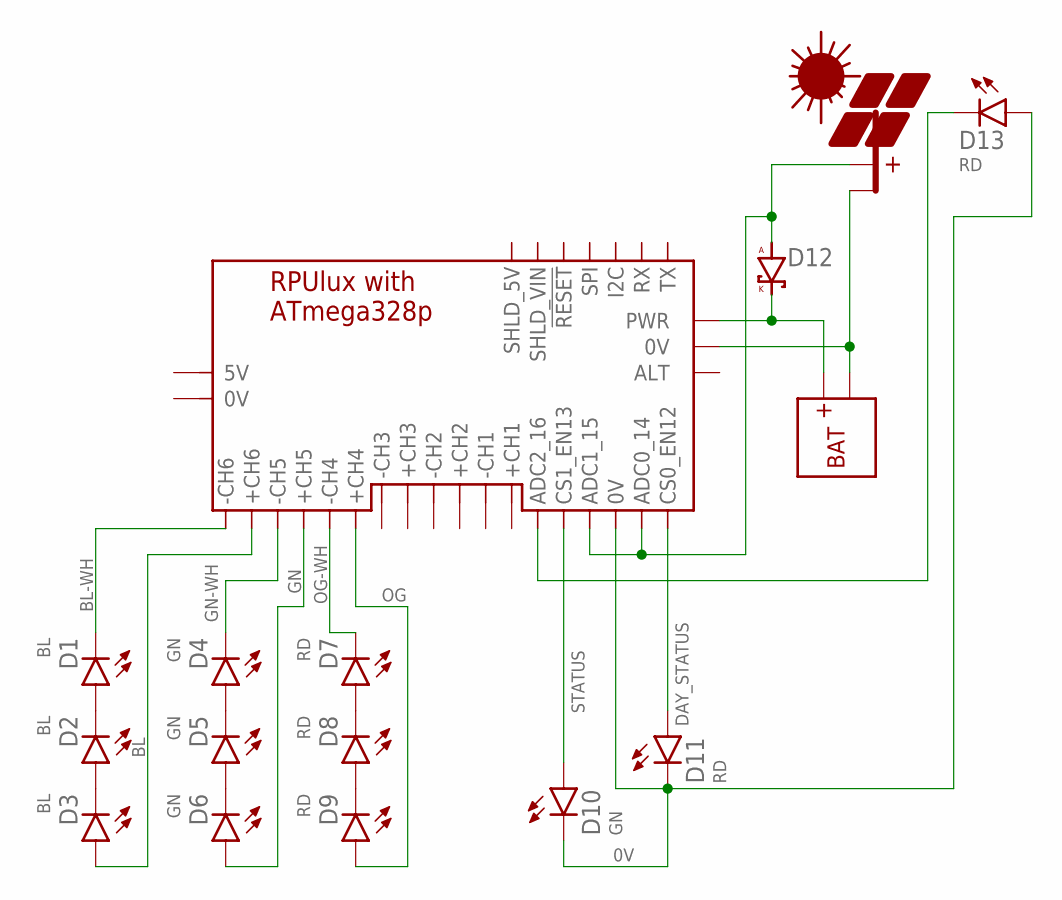
[picture p42: schematic NightLightWiring.sch]

Parts:
D1, D2, D3: BL; LED5MM
D4, D5, D6, D10: GN; LED5MM
D7, D8, D9, D11, D13: RD; LED5MM
D12: DSMB; SMB
PV2: PV; NA-30
U$1: RPULUX; WITH_RPU_NAMES
U$9: BAT; NA-30

Connections:
0V: D10.K, D11.K, D13.A, U$1.0V@DIO2 (0V)
12V: D12.K, U$1.PWR, U$9.1 (+BAT)
BL: D3.A, U$1.+CH6
BL-WH: D1.K, U$1.-CH6
DAY_STATUS: D11.A, U$1.22MA@ADC0 (CS0_EN12)
GN: D6.A, U$1.+CH5
GN-WH: D4.K, U$1.-CH5
unnamed: D4.A, D5.K
unnamed: D13.K, U$1.ADC2 (ADC2_16)
unnamed: D5.A, D6.K
unnamed: D2.A, D3.K
unnamed: D7.A, D8.K
unnamed: D1.A, D2.K
unnamed: D8.A, D9.K
unnamed: D12.A, PV2.1 (+PV), U$1.ADC0 (ADC0_14), U$1.ADC1 (ADC1_15)
unnamed: PV2.2 (-PV), U$1.0V@PWR (0V), U$9.2 (-BAT)
OG: D9.A, U$1.+CH4
OG-WH: D7.K, U$1.-CH4
STATUS: D10.A, U$1.22MA@ADC1 (CS1_EN13)
