epccs/RPUlux/SelfTest/Setup/SelfTestWiring.sch

## EAGLE design SelfTest/Setup/SelfTestWiring.sch (2018-01-22)

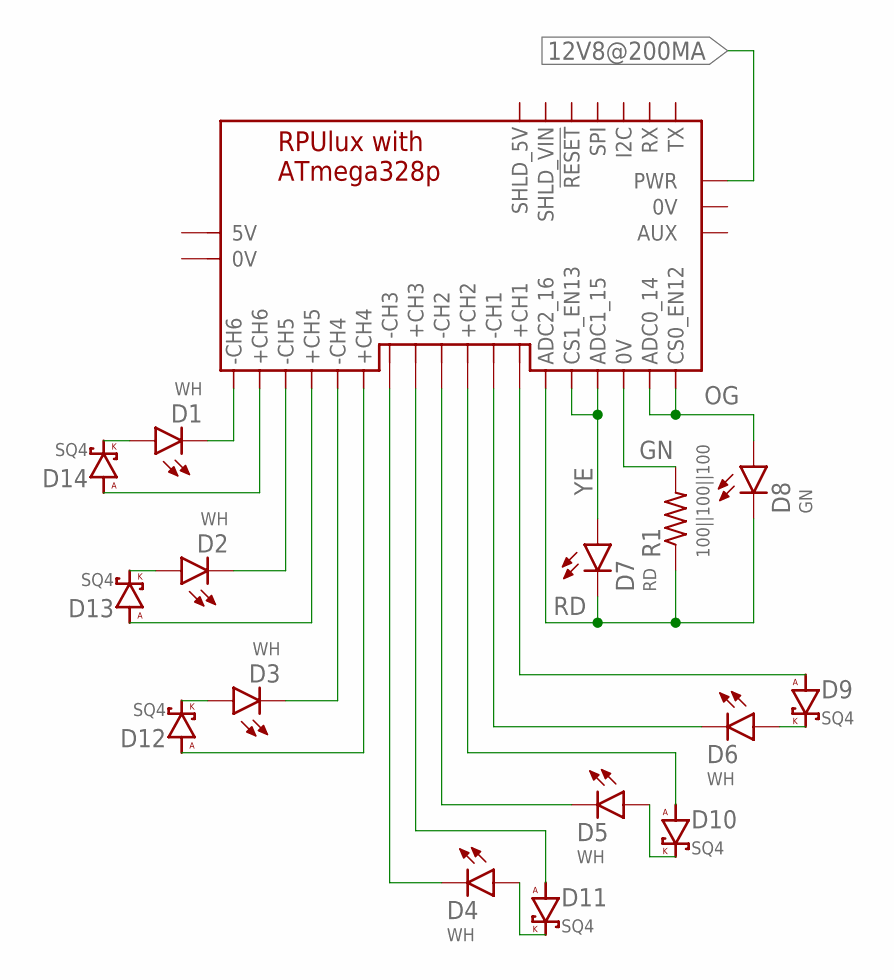
[picture p43: schematic SelfTestWiring.sch]

Parts:
D1, D2, D3, D4, D5, D6: WH; LED5MM
D7: RD; LED5MM
D8: GN; LED5MM
D9, D10, D11, D12, D13, D14: SQ4; SMA
R1: 100||100||100; C0805(2012)
U$1: RPULUX; WITH_RPU_NAMES

Connections:
12V8@200MA: U$1.PWR
GN: R1.2, U$1.0V@DIO2 (0V)
unnamed: D1.K, U$1.-CH6
unnamed: D2.K, U$1.-CH5
unnamed: D3.K, U$1.-CH4
unnamed: D4.K, U$1.-CH3
unnamed: D5.K, U$1.-CH2
unnamed: D6.K, U$1.-CH1
unnamed: D14.A, U$1.+CH6
unnamed: D13.A, U$1.+CH5
unnamed: D12.A, U$1.+CH4
unnamed: D11.A, U$1.+CH3
unnamed: D10.A, U$1.+CH2
unnamed: D9.A, U$1.+CH1
unnamed: D6.A, D9.K
unnamed: D3.A, D12.K
unnamed: D2.A, D13.K
unnamed: D1.A, D14.K
unnamed: D5.A, D10.K
unnamed: D4.A, D11.K
OG: D8.A, U$1.22MA@ADC0 (CS0_EN12), U$1.ADC0 (ADC0_14)
RD: D7.K, D8.K, R1.1, U$1.ADC2 (ADC2_16)
YE: D7.A, U$1.22MA@ADC1 (CS1_EN13), U$1.ADC1 (ADC1_15)
