epccs/RPUlux/(commit log)

2017-11-29 Hardware: add multidrop example
    [MultiDrop.sch]
2017-12-04 Hardware: bom done, and some changes made to layout, in review mode now
    [17323BRD,BOM.csv, 17323DIN,BOM.csv, 17323HDR,BOM.csv, 17323PLUG,BOM.csv, 17323SMD,BOM.csv, SolarPwrOptions.sch]
2017-12-05 Hardware: issue with zener breakdown
    [SolarPwrOptions.sch]
2017-12-16 Hardware: add aux power input
    [17323HDR,BOM.csv, 17323SMD,BOM.csv, SolarPwrOptions.sch]
2017-12-19 Hardware: solar option
    [SolarPwrOptions.sch]
2017-12-23 Hardware: ^0 reviewing done, boards on order
2018-01-13 Hardware: ^0 testing shows that pulldown needed for pwm control
    [17323HDR,BOM.csv, 17323SMD,BOM.csv]
2018-01-16 Adc and Uart added, in prep for SelfTest
2018-01-18 SelfTest: internal_1V1 and AVCC saved in eeprom
    [17323SMD,BOM.csv, SelfTestWiring.sch]
2018-01-18 Adc: now that referance is in eeprom
2018-01-21 Alternat: check if the alt power input works
    [AuxilaryWiring.sch, MultiDrop.sch]
2018-01-22 SelfTest: LED channels are running at half curr
    [AuxilaryWiring.sch, MultiDrop.sch, SelfTestWiring.sch]
2018-01-24 Hardware: ^1 updates for review
    [17323SMD,BOM.csv]
2018-01-24 Hardware: ^1 notes about ground plane
2018-01-24 Hardware: ^1 review, rm 0V under AL8805 and mv curr sense
2018-01-25 Hardware: ^1 review, 100k ohm for zener on alt pwr
    [17323SMD,BOM.csv]
2018-02-04 apps's from RPUno. AmpHr,DayNight, and i2c-debug
2018-02-06 NightLight: modified for six channels from RPUno
    [NightLightWiring.sch]
2018-02-07 Hardware: PWR_I sense, SHLD_VIN gate stress, schem header labels
    [17323SMD,BOM.csv]
2018-02-07 Hardware: solar pwr option with ssr
    [SolarPwrOptions.sch]
2018-02-07 Hardware: set the solar pwr options in order
    [SolarPwrOption_open.sch, SolarPwrOption_short.sch, SolarPwrOption_ssr.sch]
2018-02-07 Hardware: 30w pv is to much for alt input
    [SolarPwrOption_open.sch]
2018-02-15 Arduino: fade example
    [17323SMD,BOM.csv, MultiDrop.sch]
2018-02-21 Hardware: ^1 testing
    al8805 datasheet layout example oddness
    [17323SMD,BOM.csv]
2018-02-22 Hardware: ^1 evaluation, work around to get 330mA on led channels
    [17323SMD,BOM.csv, MultiDrop.sch]
2018-02-24 Hardware: ^2 layout
    [17323SMD,BOM.csv]
2018-02-26 Digital: use cli to control LED's or with python
    [17323SMD,BOM.csv]
2018-02-27 Pwm: use output compare pins for pwm waveform
2018-02-28 Pwm: use channel names
2018-03-01 Digital: use Pwm for pwm pins and digital for 14..16
2018-03-06 AmpHr: add pwm and digital
2018-03-20 Hardware: ^2 assembly done
    [17323SMD,BOM.csv]
2018-03-22 SelfTest: weak pull-up driven AL8805 ctrl pin changed to push-pull
2018-03-28 Hardware: 3k74 pull-down allows avr weak pull-up to run 100mA with analog CTRL.
    [17323SMD,BOM.csv]
2018-03-30 AmpHr: add i2c-debug, remove daynight
2018-04-04 DayNight: set a callback default, rm LED_BUILTIN
    [SolarPwrOption_short.sch, SolarPwrOption_ssr.sch]
2018-04-14 Pwm: keep Timer0 at Fast PWM mode, since micros() will not with phase correct
2018-04-25 SelfTest: led was tested, add default for twi callback
2018-04-26 i2c-debug: misleading definition
2018-04-30 CurrSour: cli for current source
2018-04-30 AmpHr: add current source control to cli
2019-09-28 timer notes for 328pb (not yet used)
